larsonma/Power-Supplies-2/img/Transformer Step Down Voltage.jpg

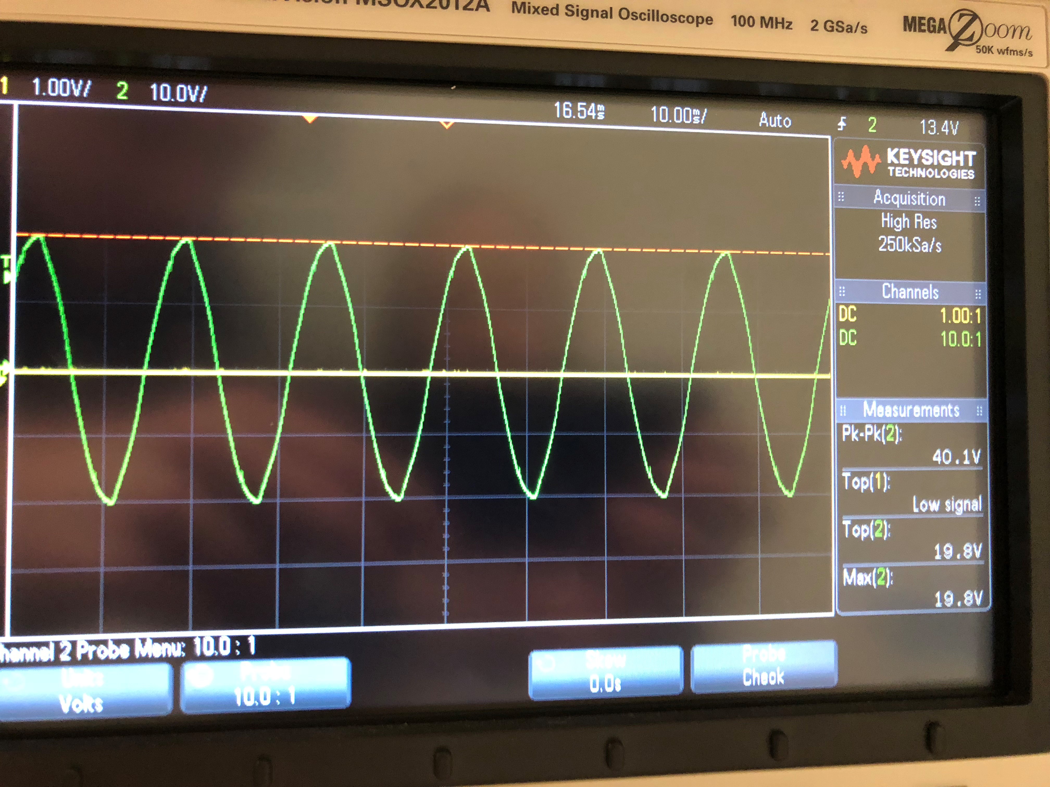
img/Transformer Step Down Voltage.jpg
