larsonma/Power-Supplies-2/img/Design Circuit.jpg

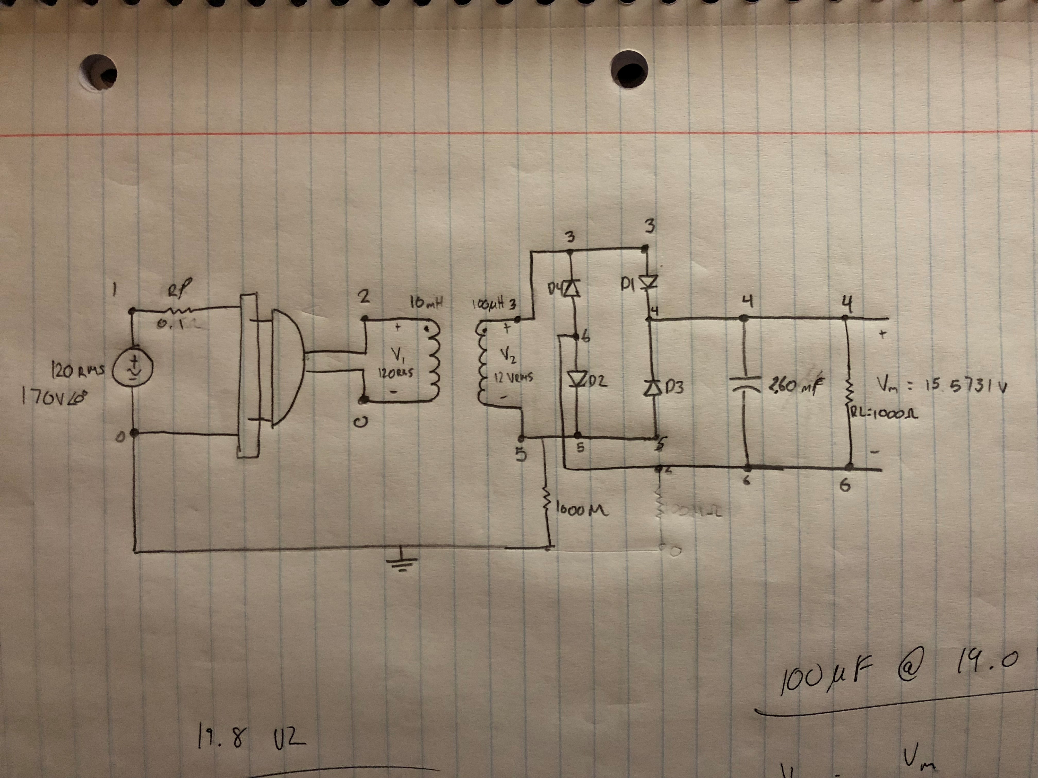
img/Design Circuit.jpg
