larsonma/Power-Supplies-2/img/3 mF capacitor ripple voltage.jpg

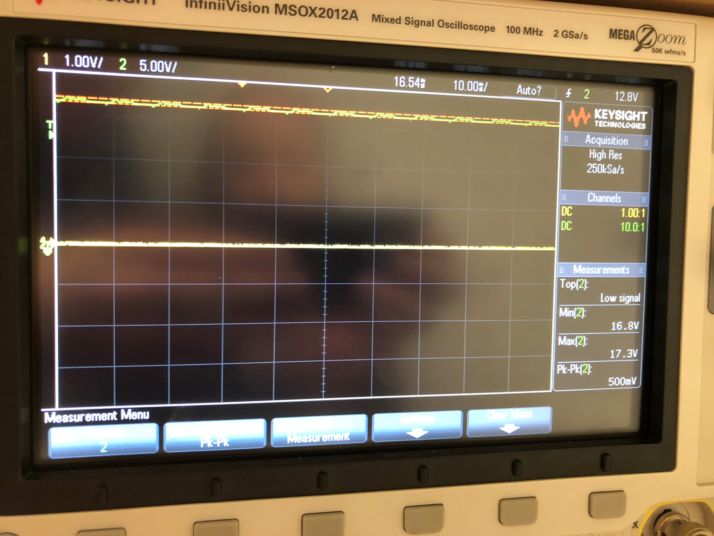
img/3 mF capacitor ripple voltage.jpg
