larsonma/Power-Supplies-2/img/100 Ohm Ammeter.jpg

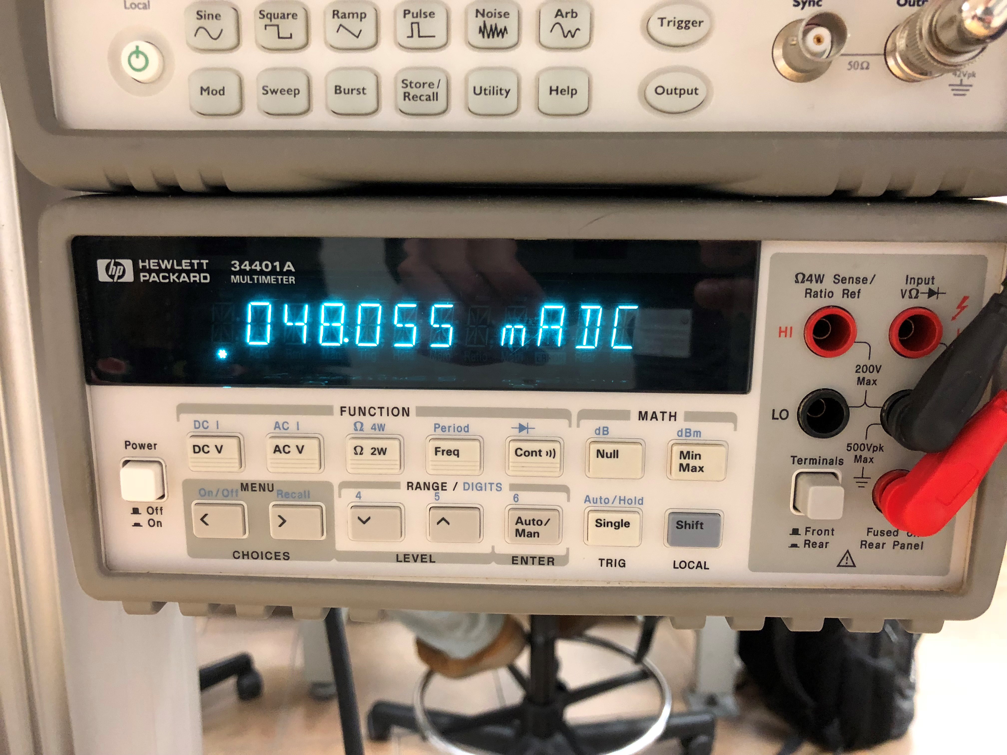
img/100 Ohm Ammeter.jpg
