larsonma/Power-Supplies-2/img/100 uF capacitor ripple voltage.jpg

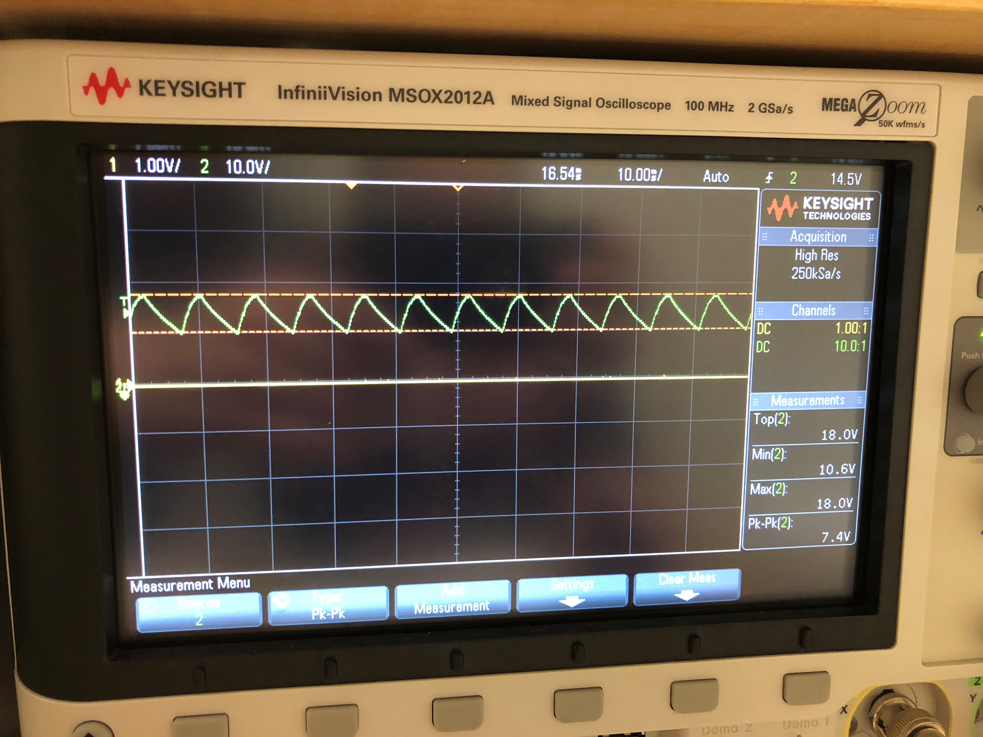
img/100 uF capacitor ripple voltage.jpg
