larsonma/Power-Supplies-2/img/4700 Ohm Ammeter.jpg

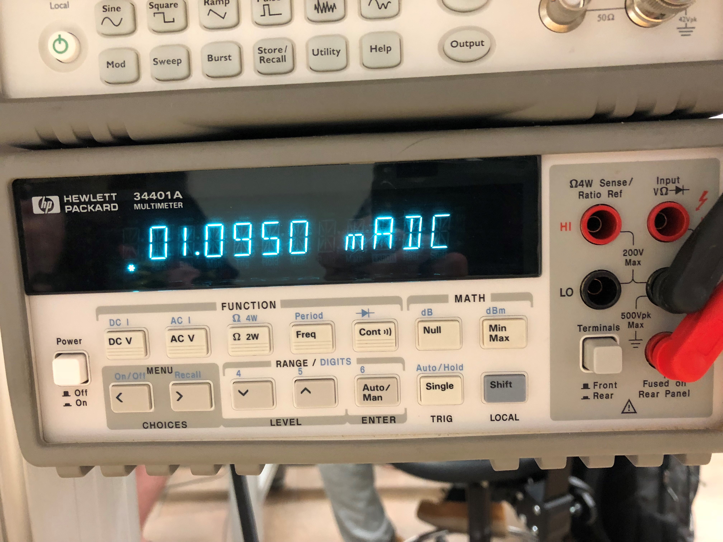
img/4700 Ohm Ammeter.jpg
