larsonma/Power-Supplies-2/img/Design Simulation.PNG

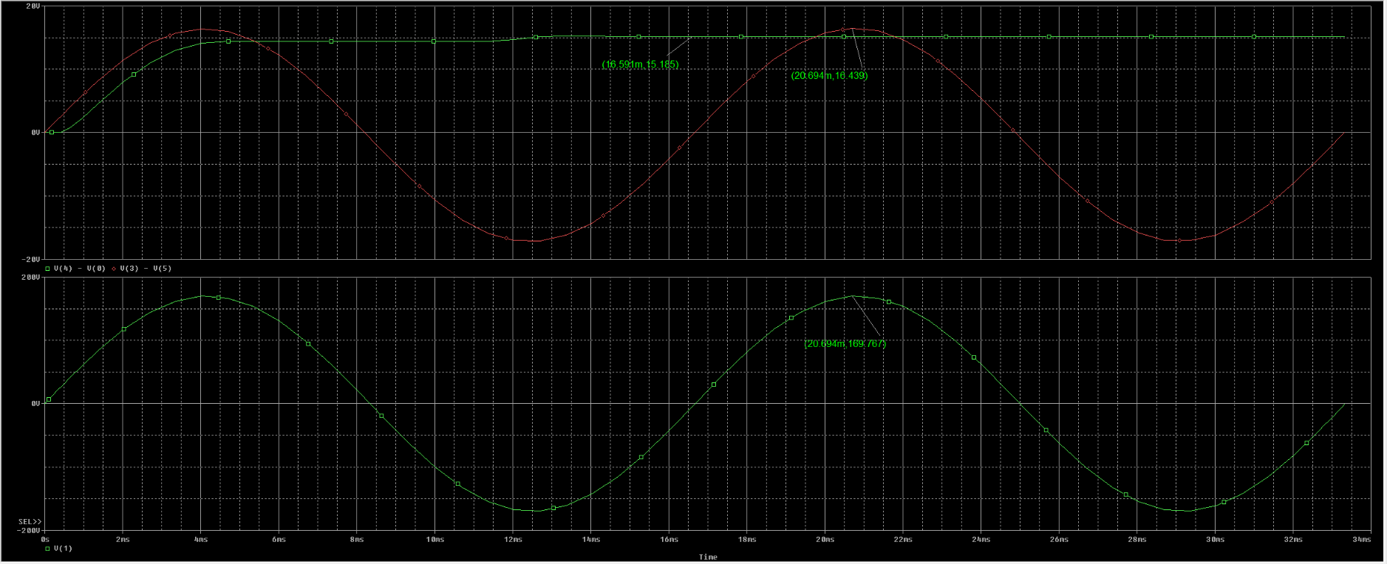
img/Design Simulation.PNG
