larsonma/Power-Supplies-2/img/Rectified Voltage.jpg

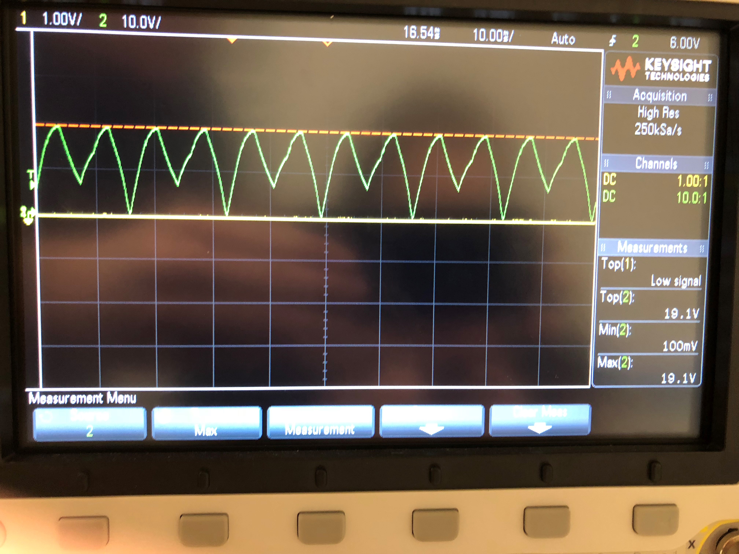
img/Rectified Voltage.jpg
