larsonma/Power-Supplies-2/img/regulator output.jpg

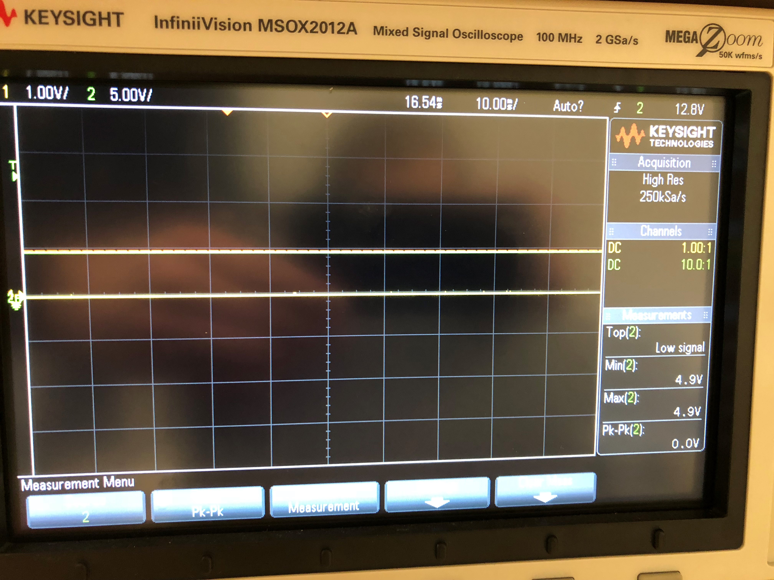
img/regulator output.jpg
