larsonma/Power-Supplies-2/CE 3101 Lab Experiment 4.pdf

Mitchell Larson
CE 3101
Lab 4
4/2/18

# CE 3101 Lab Experiment 4

## Abstract

In the field of consumer digital electronics, circuits that convert high AC voltage into a much lower DC voltage are essential. These types of devices can be found nearly anywhere where a digital logic circuit is used. In most scenarios, a converter can just be bought which will allow a DC electronic circuit to work, but building an AC to DC converter provides an invaluable experience that helps broaden understanding of electronics, while providing insight into the history of the consumer electronics industry. The AC to DC converter is made up of several different components that each satisfy a unique portion of the design. A transformer first steps down the voltage from the wall socket to a value much closer to the desired DC voltage. After the step down, the AC signal is then rectified so that it provides power during both the positive and negative portions of the sinusoidal signal. Next, a filter capacitor is used to hold the voltage at a near-constant value, allowing for a small amount of ripple voltage. Finally, a regulator is used to hold the DC voltage output constant, regardless of current pull and environmental thermal characteristics.

In this lab, the goal was to build the circuit described above. To do so, the transformer, diode rectifier, and filter capacitor portions of the circuit were designed, and then tested in PSPICE to verify correct behavior. Following successful verification of the design, the AC to DC converter was built one stage at a time, starting with the transformer (provided by the MSOE EECS tech department). After successful verification of each stage, the next stage of the design was completed. Note that the regulator was not designed or built in this lab; rather, an IC chip provided by the EECS tech department was used. During the build, different filter capacitors and load resistors were used so that the effects of each could be observed and analyzed. Upon completion of the experiment, an oscilloscope was used to verify correct design and implementation of the converter. Consequently, the lab was concluded to be successful with a high level of confidence in the findings of the experiment.

Lab 4
4/2/18

## Experiment

### Design

To provide a constant 5V DC output voltage, with a secondary stepped-down voltage set at 12 VRMS, a ripple of 0.5V, a load resistance of 100 Ω, and diodes modeled after the DB101 full-wave bridge rectifier, the following design was constructed.

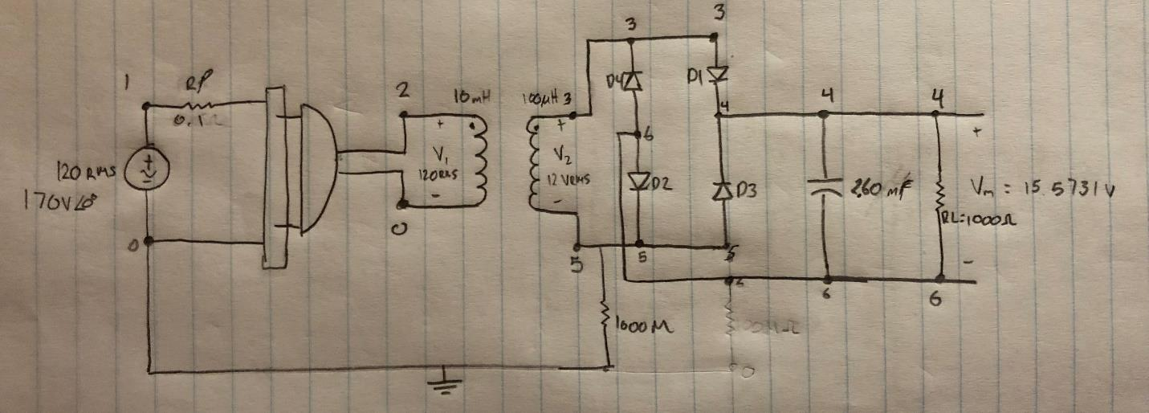
[picture p10: figure]

Figure 1 - Design of unregulated 5V power supply

To verify its behavior, it was simulated using PSPICE. The following trace illustrates the simulation results.

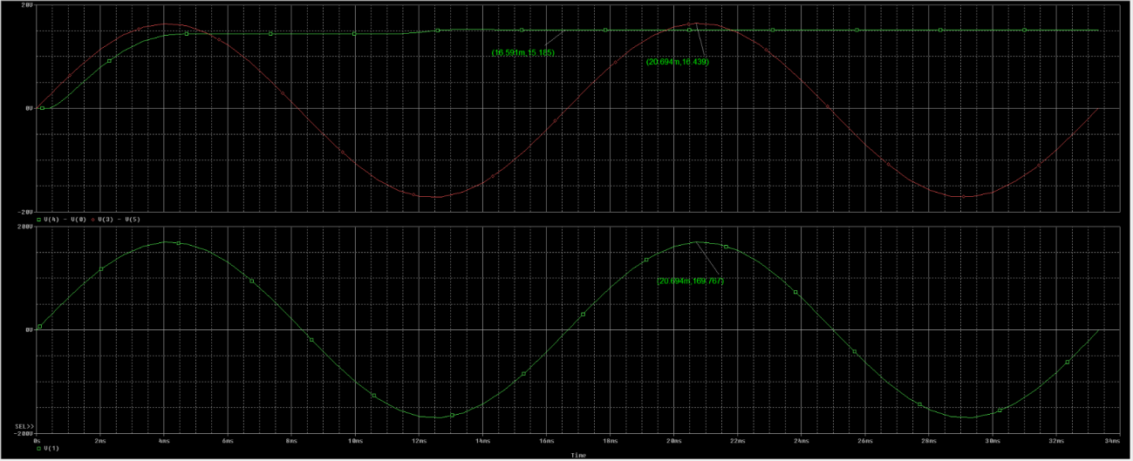
[picture p11: figure]

Figure 2 - PSPICE simulation of design circuit.

While the voltage measured across the load resistor (15.185 V) does not match the value derived in the design (15.573 V), it was close enough to provide verification of design. Its important to remember that

Lab 4
4/2/18
the diodes and transformer model being used in the PSPICE simulation were only approximations, and do not perfectly model ideal components. With simulation results close to the values expected, and behavior that is consistent with the theoretical behavior of the design, it was declared safe to implement the designed circuit.

### Transformer Verification

The first portion of the design implemented was the transformer. Since this was provided by the EECS tech department, only a simple verification of step down voltage was needed. A 10X oscilloscope was used to measure the output of the transformer as it was connected to US main. The transformer was expected to step voltage down to a value near 17 V, but variation was expected.The following image illustrates the findings.

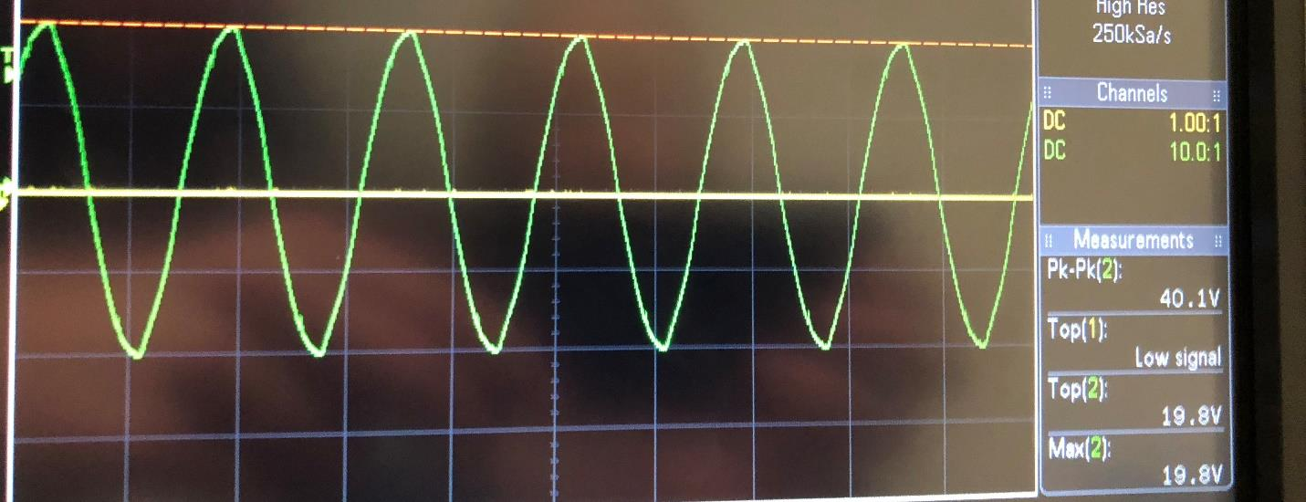
[picture p12: figure]

Figure 3 - Oscilloscope view of stepped down voltage.

As expected, voltage was stepped down to a value closer to 17V, with slight variation. In reality, the implemented circuit would need to handle a secondary voltage of 19.8V.

Lab 4
4/2/18

### Full Bridge Rectifier

A full bridge rectifier chip was placed in the circuit implementation next, and its output was measured with the oscilloscope to verify that the secondary voltage was being successfully rectified. An image of the oscilloscope is attached below.

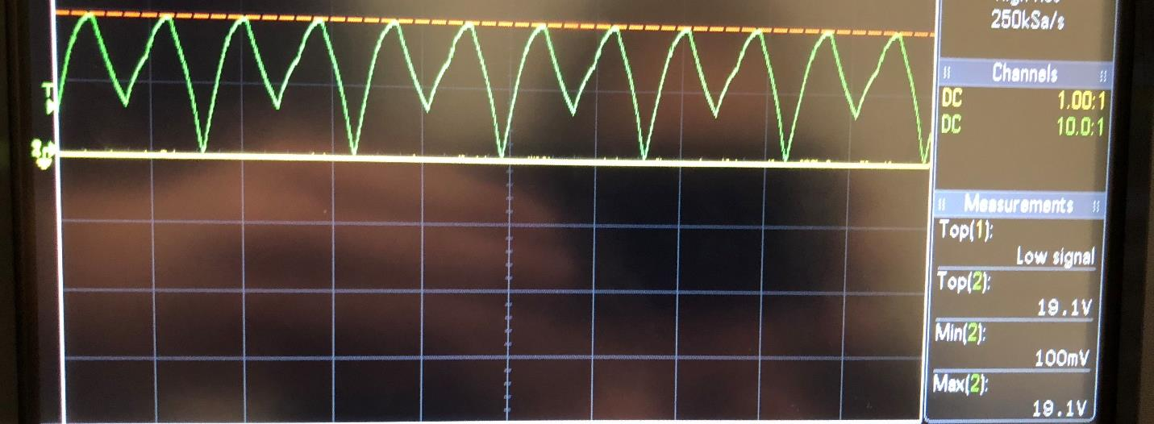
[picture p13: figure]

Figure 4 - Oscilloscope view of full bridge rectifier output

The oscilloscope verified that the negative portions of secondary voltage were being rectified so that the full period of secondary voltage was being used. The peak voltage dropped from 19.8V to 19.1V (0.7V) difference after going through rectification.

### 100 µF Capacitor

Initially, a 100 µf capacitor was used as the filter capacitor in the implemented circuit. This was different from the design, and as a result, a new ripple voltage would occur. This ripple voltage was calculated to be:

19.1 | 15.92
2*60 | *100 *100 r

V
V | V
Hz | Fµ
= | =
Ω

A 100Ω 5W resistor was added to the circuit so that the ripple voltage could be measured and compared against the calculated value. The results are shown below:

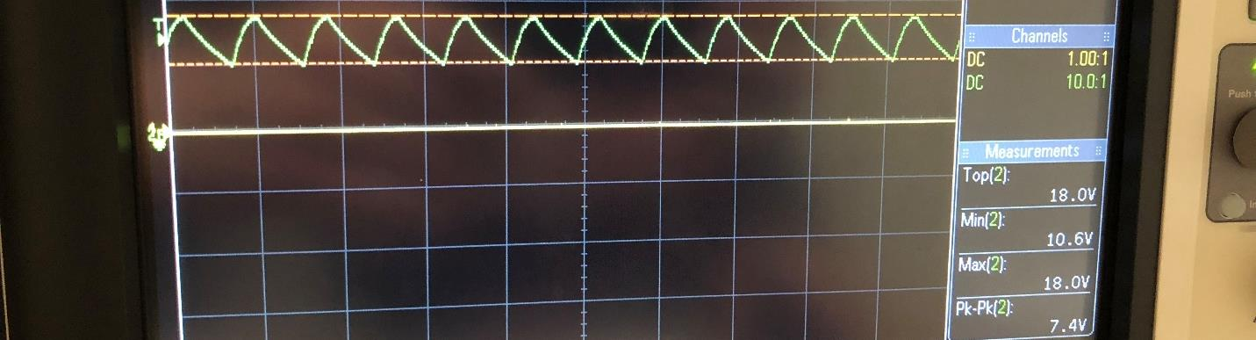
[picture p14: figure]

Figure 5 - Oscilloscope capture of ripple voltage with 100 uF filter capacitor.

Lab 4
4/2/18
The results were surprising at first – a ripple of almost 16V was expected, yet the measured ripple was only 7.4V. While this didn’t seem to make sense at first glance, the reason for the severe discrepancy was due to the fact that the equation used to calculate ripple voltage only works for small amounts of ripple voltage. The equation used approximates a differential equation, and when the resulting ripple voltage approaches larger values, it begins to break down. If the actual ripple voltage calculation was needed for ripple voltage that large, the differential equation would be necessary, and the linear approximation would be inappropriate. While the ripple voltage was different than expected, the oscilloscope was able to verify that the load was causing a ripple voltage.

The minimum and maximum current experienced by the load resistor due to the ripple voltage were:

min

10.6 106
100

V
i | mA = | =
Ω

max

18.0 180
100

V
i | mA = | =
Ω

The minimum and maximum power experienced by the load resistor due to the ripple voltage were:

min p | mA | V | W = | = 106 | *10.6 | 1.12 max p | mA | V | W = | = 180 | *18.0 | 3.24

### Actual Filter Capacitor

The filter calculation was redone according to the actual rectified maximum amplitude voltage. This resulted in a filter capacitor of:

19.1 | 3.18
2*60 | *100 *0.5 F

V
C | mF
Hz | V
= | =
Ω

With the actual rectified maximum amplitude voltage, the filter capacitor capacitance increased slightly from a design value of 2.60 µF to 3.18µF.

The 100 µF capacitor was replaced with 2 1500 µF capacitors in parallel to approximate the new filter capacitance. This resulted in the following ripple:

Lab 4
4/2/18

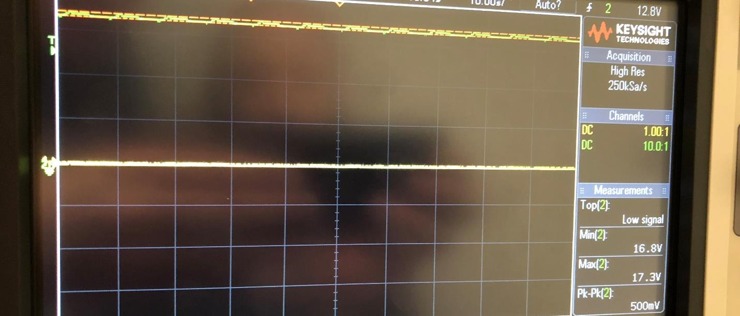
[picture p15: figure]

Figure 6 - Oscilloscope capture of ripple voltage for approximation of 3.18 mF capacitor.

When placing an approximation of the correct filter capacitor, a correct ripple voltage of 0.5 V is obtained. With this new ripple voltage,

The minimum and maximum current experienced by the load resistor due to the ripple voltage were:

min

16.8 168
100

V
i | mA = | =
Ω

max

17.3 173
100

V
i | mA = | =
Ω

The minimum and maximum power experienced by the load resistor due to the ripple voltage were:

min p | mA | V | W = | = 168 | *16.8 | 2.82 max p | mA | V | W = | = 173 | *17.3 | 2.99

### 7805 Regulator

Next, the 7805 regulator was placed in the circuit to finish the design. This component was expected to create a constant DC output of 5V. A load resistor was placed in the circuit of 100 Ω, and the following ripple was observed.

Lab 4
4/2/18

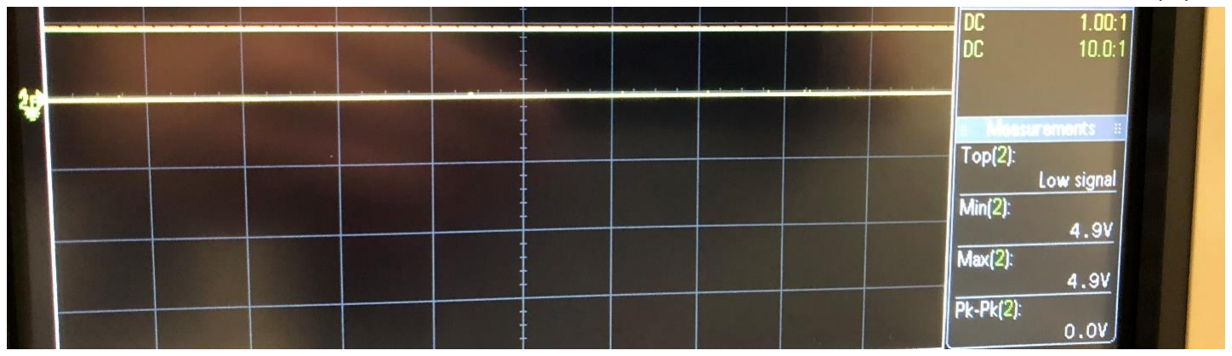
[picture p16: figure]

Figure 7 - Oscilloscope capture of regulator output.

As expected, a constant voltage was output from the regulator – the ripple was reduced to the point that the oscilloscope could not read it. Due to this, the load experiences the same minimum and maximum currents and powers. They were calculated to be:

The current experienced by the load resistor due to the ripple voltage were:

min

4.9 49
100

V
i | mA = | =
Ω

The power experienced by the load resistor due to the ripple voltage were:

min p | mA | V | W = | = 49 | *4.9 | 0.24

An ammeter was inserted into the circuit to verify the calculated current experienced by the load.

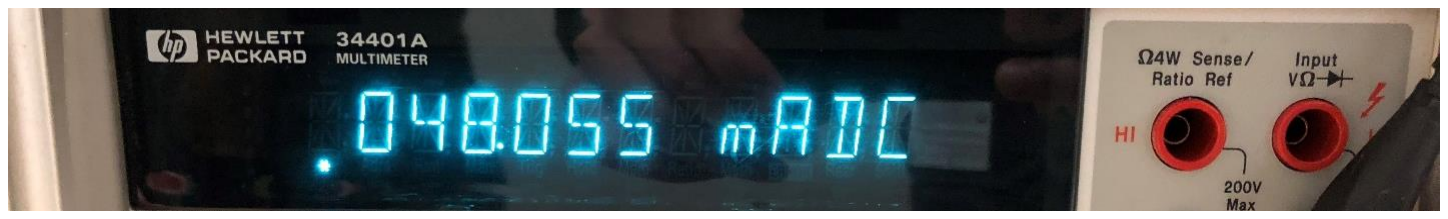
[picture p17: figure]

Figure 8 - Ammeter measurement for 100 Ohm load.

The current measured from the ammeter was really close to the expected value of 49mA, with minor differences most likely caused by minute differences between ideal components and physical components.

### 4.7 KΩ Load

To simulate a larger load, the 100 Ω load was swapped with a 4.7 KΩ load and the previous step was repeated. The oscilloscope showed a ripple voltage exactly the same as what was shown in the previous image of the ripple voltage for a 100 Ω load. The larger load did however, lead to a new current and power experienced by the load (again, because of a 0V ripple, the minimum and maximum currents and powers were identical, respectively).

Lab 4
4/2/18
The current experienced by the load resistor due to the ripple voltage were:

min

4.9 1.0
4700

V
i | mA = | =
Ω

The power experienced by the load resistor due to the ripple voltage were:

min p | mA | V | mW = | = 1.0 | *4.9 | 4.9

Again, an ammeter was inserted into the circuit to verify the current experienced by the load resistor.

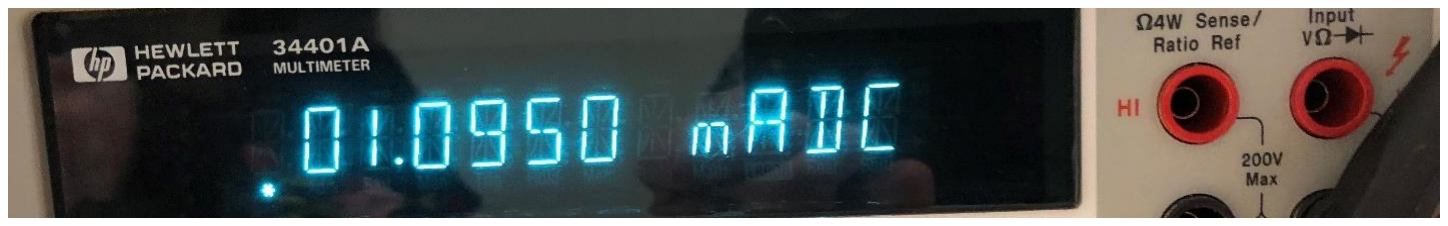
[picture p18: figure]

Figure 9 - Ammeter measurement for 4700 Ohm load.

Again, just as with the 100 Ω load, the ammeter seemed to verify the calculations made for current experienced by the load. Similar to the 100 Ω load, small differences were observed, but were most likely due to differences between theoretical components and physical components.

## Conclusion

In the end, this lab was extremely successful in fortifying theory taught in the classroom. Prior to this lab, only portions of the converter (such as half and full bridge rectifiers) had been implemented in lab, and most theory had only been simulated in PSPICE. While that provided a good theoretical understanding of the material, physical implementation of circuits usually deviates slightly from design. This is something that never happens in simulation, since components are typically modeled to a point that they appear almost as ideal. In this lab experiment however, design sacrifices had to be made, and this lab experiment helped teach how they can, and should be made. Additionally, it was helpful designing the full AC to DC converted step by step, verifying behavior at each point. Due to this, as well as the results of the circuit implementation, it would be reasonable to declare this experiment a success.
